Satsuma3D/Satsuma-250/README.md

# Satsuma 250

This project is incomplete. I might pick it up one day, or you are welcome to yourselves.

GPLv3 Licensed.

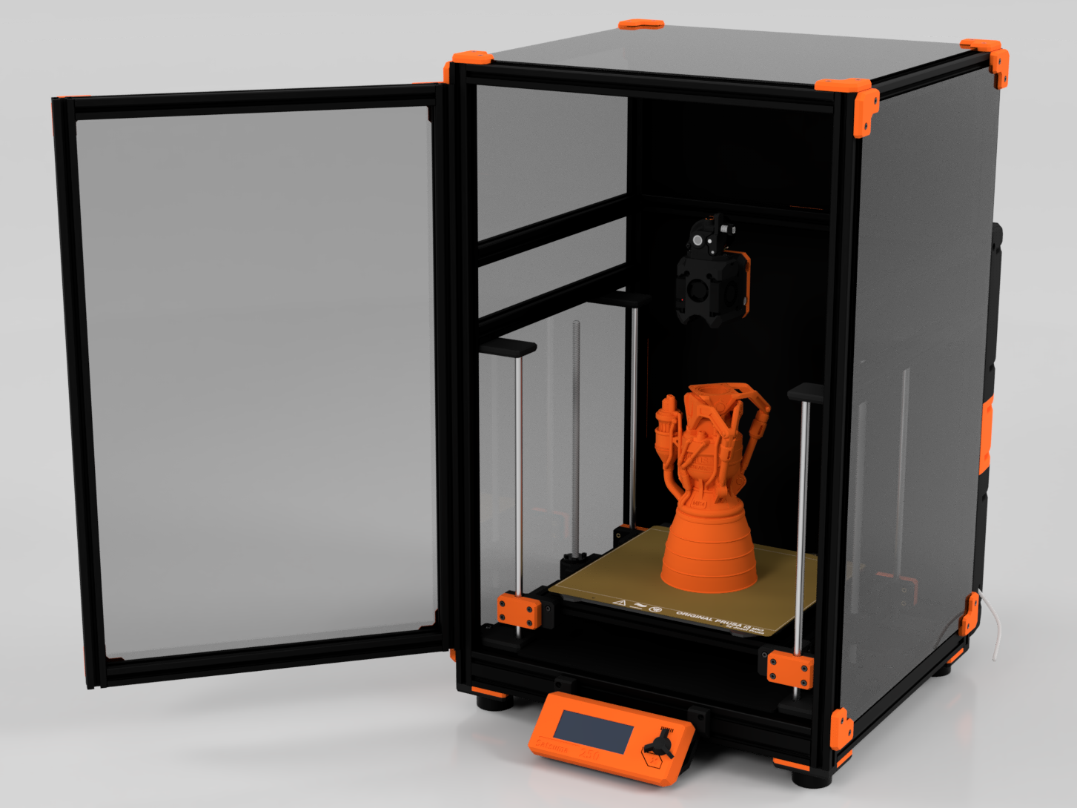
[picture p1: Assets/satsuma_250_front_render.png]
Front Render


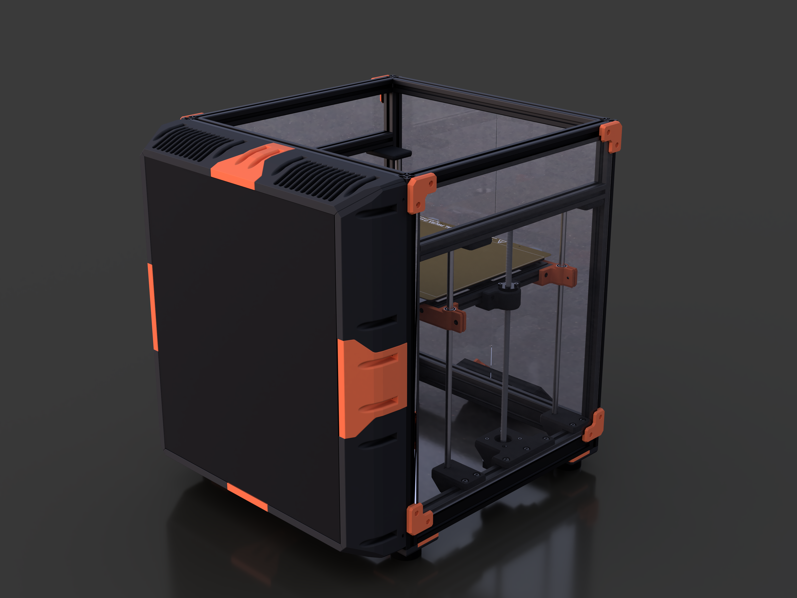
[picture p2: Assets/satsuma_250_rear_render.png]
Rear Render
