Satsuma3D/Satsuma-250/Assets/satsuma_250_electronics_bay.png

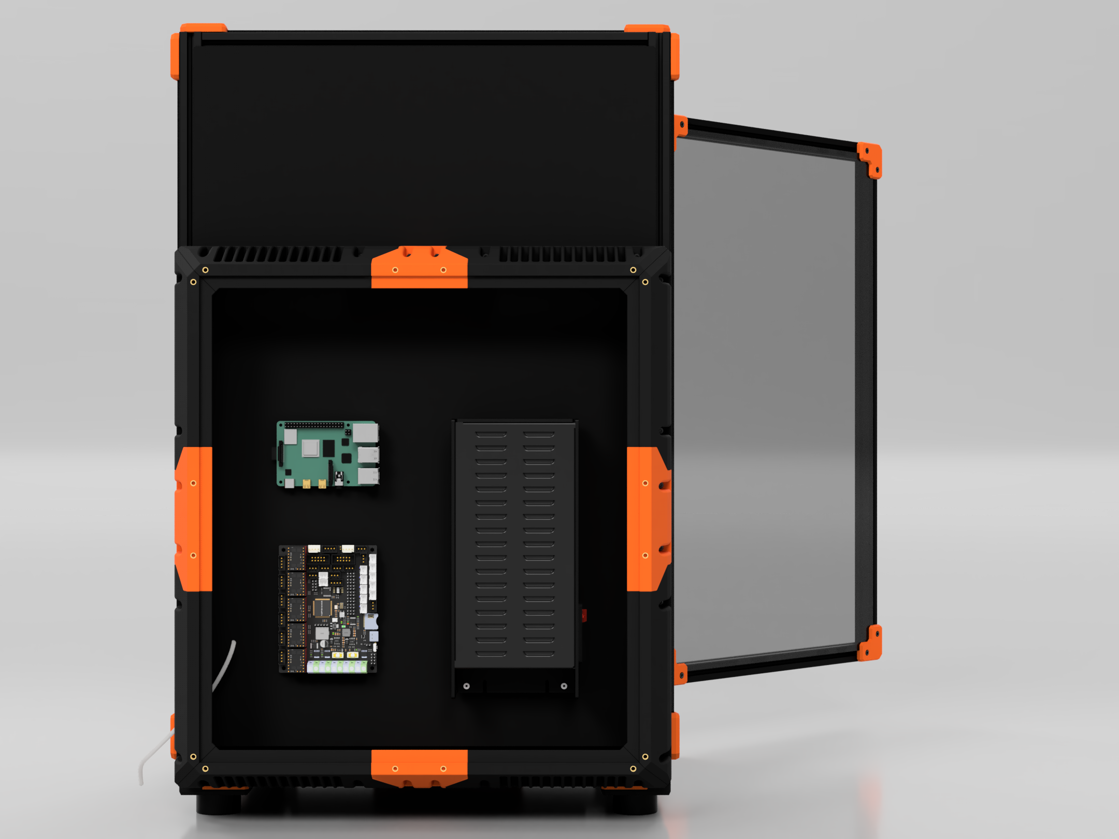
Assets/satsuma_250_electronics_bay.png
