Satsuma3D/Satsuma-250/Bill of Materials.ods

Item | Quantity | Selected | Selected Price | Selected Subtotal | Europe Price | Prusa Price | AliExpress Price | Europe Subtotal Price | Prusa Subtotal Price | AliExpress Subtotal Price | Europe | Prusa | AliExpress
3mm x 250mm Stainless 304 Rod | 4 | AliExpress | €1.25 | €4.98 | €1.25 | €1.25 | €1.25 | €4.98 | €4.98 | €4.98 |  | Unavailable | https://www.aliexpress.com/item/1005006238408009.html
8mm x 330mm Stainless 304 Rod | 2 | AliExpress | €6.14 | €12.28 | €13.53 | €11.99 | €6.14 | €27.06 | €23.98 | €12.28 |  | https://www.prusa3d.com/en/product/smooth-rod-y-axis-mk4-mk3-s-mk2-5-s-mk2-s/ | https://www.aliexpress.com/item/1005006238408009.html
8mm x 370mm Stainless 304 Rod | 2 | AliExpress | €7.50 | €15.00 | €15.17 | €11.99 | €7.50 | €30.34 | €23.98 | €15.00 |  | https://www.prusa3d.com/en/product/smooth-rod-x-axis-mk4-mk3-s-mk2-5-s-mk2-s/ | https://www.aliexpress.com/item/32697715625.html
8mm x 320mm Stainless 304 Rod | 4 | AliExpress | €6.07 | €24.26 | €13.12 | €11.64 | €6.07 | €52.48 | €46.56 | €24.26 |  | https://www.prusa3d.com/en/product/smooth-rod-z-axis-mk3-s-mk2-5-s-mk2-s/ | https://www.aliexpress.com/item/32761168449.html
Prusa MK3/MK4 Y Carriage | 1 | Europe | €37.73 | €37.73 | €36.49 | €37.90 | €37.73 | €36.49 | €37.90 | €37.73 | Hobby Store (Poland) https://hobby-store.pl/en/heated-beds/y-axis-carriage-replacement-for-prusa-i3-mk3.html | https://www.prusa3d.com/en/product/y-carriage/ | https://www.aliexpress.com/item/1005006019454008.html
Prusa MK52 Heated Bed 24V | 1 | Europe | €91.45 | €91.45 | €91.45 | €109.00 | €60.74 | €91.45 | €109.00 | €60.74 | Lecktor https://lecktor.com/en/heated-beds/30-mk52-24v-heated-bed.html | https://www.prusa3d.com/en/product/heatbed-mk52-24v-xbuddy-replacement-set/ | https://www.aliexpress.com/item/1005006074818817.html
TR8x4 Trapezoid Lead Screw Nut | 2 | Prusa | €13.94 | €27.88 |  | €13.94 | €0.00 | €0.00 | €27.88 | €0.00 |  | https://www.prusa3d.com/en/product/trapezoid-nut-i3-mk4-mmu2-2s-3/ | Blurolls included if you buy their motor
5015 Blower Fan 24V | 1 | Prusa | €7.49 | €7.49 |  | €7.49 | €14.22 | €0.00 | €7.49 | €14.22 |  | Not 24V but is 5V, will need wiring to 5V if you intend to pair it with the SKR Mini E3 https://www.prusa3d.com/en/product/print-fan/ | https://www.aliexpress.com/item/1005002065432445.html
4010 Hotend Fan 24V | 1 | Prusa | €13.49 | €13.49 |  | €13.49 | €12.12 | €0.00 | €13.49 | €12.12 |  | Not 24V but is 5V, will need wiring to 5V if you intend to pair it with the SKR Mini E3 https://www.prusa3d.com/en/product/hotend-fan-mk3-s/ | https://www.aliexpress.com/item/32726640438.html
F623 Bearing | 20 | Europe | €0.84 | €16.80 | €0.84 | €5.80 | €0.50 | €16.80 | €116.00 | €10.08 | Hobby Store (Poland) https://hobby-store.pl/en/ball-bearings/flanged-bearing-f623-rs-3x11x4mm.html | Not a direct equivalent, please use F623s as these will not work https://www.prusa3d.com/en/product/bearing-housing-623h/ | Mellow https://www.aliexpress.com/item/32660308298.html
Prusa X Motor | 1 | Europe | €24.75 | €24.75 | €24.75 | €38.89 | €34.33 | €24.75 | €38.89 | €34.33 | Jacks Filament (bundle, genuine LDO) Contains the extruder motor which will not be used https://www.jacksfilament.com/LDO-Prusa-MK3-Motor-Stepper-Kit | https://www.prusa3d.com/en/product/stepper-motor-x-axis-mk3-s-mk2-5-s-mk2-s/ | Blurolls Moons https://www.aliexpress.com/item/4001217753699.html
Prusa Y Motor | 1 | Europe | €24.75 | €24.75 | €24.75 | €38.39 | €34.33 | €24.75 | €38.39 | €34.33 | Jacks Filament (bundle, genuine LDO) Contains the extruder motor which will not be used https://www.jacksfilament.com/LDO-Prusa-MK3-Motor-Stepper-Kit | https://www.prusa3d.com/en/product/stepper-motor-y-axis-mk3-s-mk2-5-s-mk2-s/ | Blurolls Moons https://www.aliexpress.com/item/4001217753699.html
Prusa Z Axis Motor with R8x4 Lead Screw | 2 | Prusa | €38.89 | €77.78 |  | €38.89 | €34.10 | €0.00 | €77.78 | €68.20 |  | https://www.prusa3d.com/en/product/stepper-motor-z-axis-right-mk3-s-mk2-5-s-mk2-s/ | https://www.aliexpress.com/item/4001346400285.html
 |  |  |  | Selected Total |  |  |  | Europe Total | Prusa Total | AliExpress Total |  | Savings by not buying Prusa
 |  |  |  | €378.64 |  |  |  | €309.10 | €566.32 | €328.27 |  | €187.68
