Satsuma3D/Satsuma-250/Printed Parts/STEP/Bed Assembly/z_bearing_holder_a_x2.step

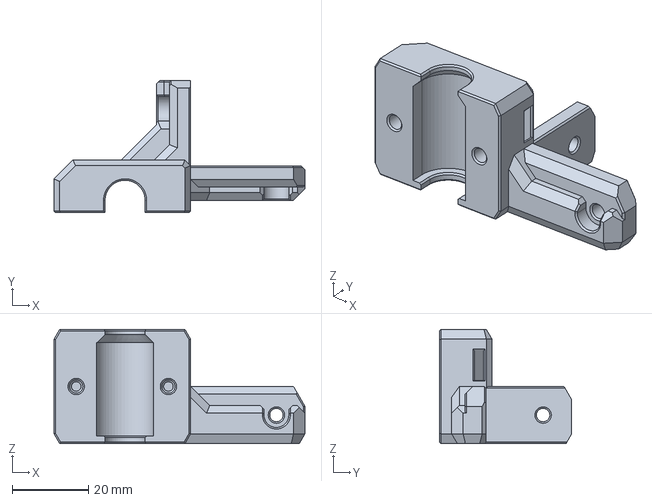
[picture p4: CAD file, 2024-11-23]
Printed Parts/STEP/Bed Assembly/z_bearing_holder_a_x2.step
65.8 x 34.8 x 30.0 mm
