Satsuma3D/Satsuma-250/Printed Parts/STEP/Z Axis/z_axis_bottom_x2.step

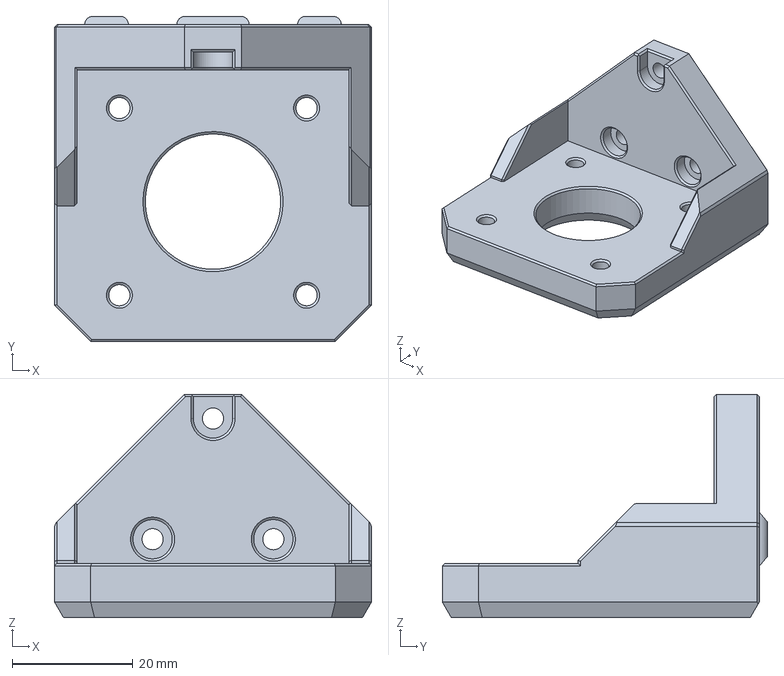
[picture p5: CAD file, 2024-11-23]
Printed Parts/STEP/Z Axis/z_axis_bottom_x2.step
52.5 x 53.9 x 37.0 mm
