Satsuma3D/Satsuma-250/Printed Parts/STEP/Bed Assembly/[a]_z_bearing_clamp_x4.step

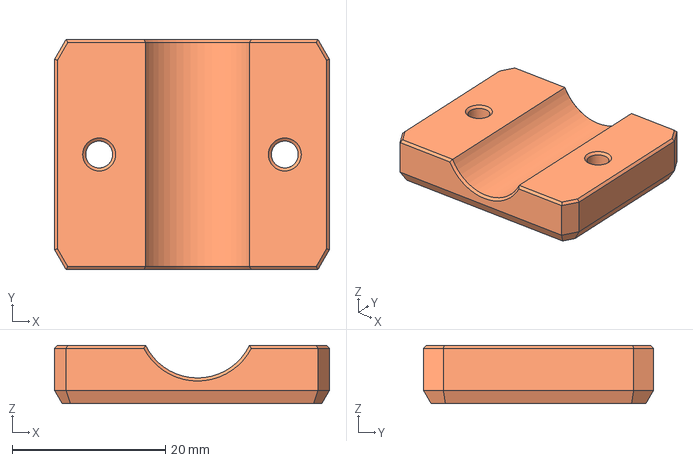
[picture p6: CAD file, 2024-11-23]
Printed Parts/STEP/Bed Assembly/[a]_z_bearing_clamp_x4.step
35.9 x 30.0 x 7.60 mm
