Satsuma3D/Satsuma-250/Printed Parts/STEP/Z Axis/z_rod_bottom_x4.step

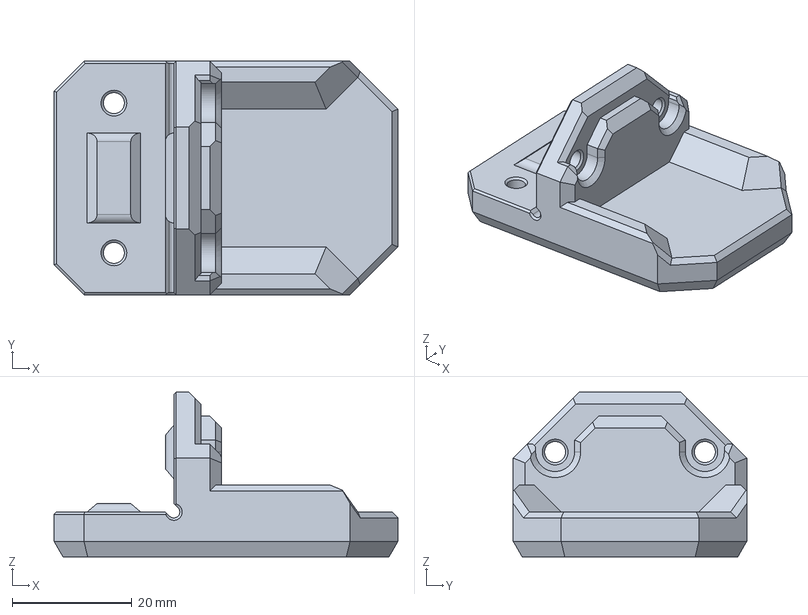
[picture p7: CAD file, 2024-11-23]
Printed Parts/STEP/Z Axis/z_rod_bottom_x4.step
57.4 x 39.0 x 27.5 mm
