Satsuma3D/Satsuma-250/Printed Parts/STEP/Z Axis/[a]_z_rod_top_b_x2.step

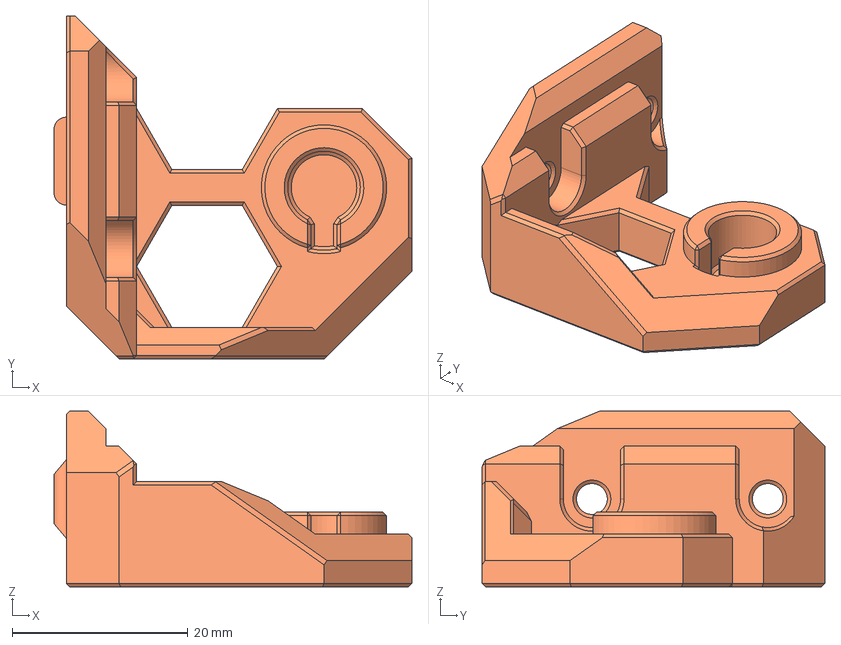
[picture p8: CAD file, 2024-11-23]
Printed Parts/STEP/Z Axis/[a]_z_rod_top_b_x2.step
40.7 x 39.0 x 20.0 mm
