Satsuma3D/Satsuma-250/(list of files, cad)

Other CAD files:
Printed Parts/STEP/Z Axis/[a]_z_rod_top_a_x2.step
CAD/Clementine 240.f3d
Printed Parts/F3D/Bed Assembly/[a]_z_bearing_clamp_x4.f3d
Printed Parts/F3D/Bed Assembly/z_bearing_holder_a_x2.f3d
Printed Parts/F3D/Z Axis/[a]_z_rod_top_a_x2.f3d
Printed Parts/F3D/Z Axis/[a]_z_rod_top_b_x2.f3d
Printed Parts/F3D/Z Axis/z_axis_bottom_x2.f3d
Printed Parts/F3D/Z Axis/z_rod_bottom_x4.f3d
Printed Parts/STL/Bed Assembly/[a]_z_bearing_clamp_x4.stl
Printed Parts/STL/Bed Assembly/z_bearing_holder_a_x2.stl
Printed Parts/STL/Z Axis/[a]_z_rod_top_a_x2.stl
Printed Parts/STL/Z Axis/[a]_z_rod_top_b_x2.stl
Printed Parts/STL/Z Axis/z_axis_bottom_x2.stl
Printed Parts/STL/Z Axis/z_rod_bottom_x4.stl
