Satsuma3D/Satsuma-250/(commit log)

2024-03-17 Update CAD
2024-03-18 Single Y extrusions
2024-03-29 CT36 Toolhead PCB
    [2132282210.step, 436500210.step, 5023860270.step, 5023860370.step, 5023860470.step, Bill of Materials.ods, toolhead_board.kicad_pcb, toolhead_board.kicad_sch]
2024-03-29 4 layer board
    [5023820470.step, toolhead_board.kicad_pcb, toolhead_board.kicad_sch]
2024-03-29 Belt paths
2024-03-30 New A/B motor assemblies
2024-03-30 Bridge cutting A/B mounts, Git LFS
    [2132282210.step, 436500210.step, 5023820470.step, 5023860270.step, 5023860370.step, 5023860470.step]
2024-03-30 Add blind joints to frame
    [Clementine 240.f3d]
2024-03-30 Front frame blind joints are different; add gantry fasteners
    [Clementine 240.f3d]
2024-03-30 Fix side panel sizing
    [Clementine 240.f3d]
2024-03-30 Y endstop pod
    [Clementine 240.f3d]
2024-03-30 Cleanup the look of that ugly door
    [Clementine 240.f3d]
2024-03-30 Nicer side panels
    [Clementine 240.f3d]
2024-03-31 XY Joints
    [Clementine 240.f3d]
2024-04-01 Front idlers - cheers, Clee
    [Clementine 240.f3d]
2024-04-01 Electronics re-jig, cleaner XY joint tops
    [Clementine 240.f3d]
2024-04-01 Use filtered mains inlets
    [Clementine 240.f3d]
2024-04-01 Begun filtered mains IEC
    [Clementine 240.f3d]
2024-04-03 Frame updates
    [Clementine 240.f3d, Toolhead.f3d]
2024-04-03 Remove Git LFS
    [2132282210.step, 436500210.step, 5023820470.step, 5023860270.step, 5023860370.step, 5023860470.step, Toolhead.f3d]
2024-04-23 Satsuma 250 from here on
    [2132282210.step, 436500210.step, 5023820470.step, 5023860270.step, 5023860370.step, 5023860470.step, toolhead_board.kicad_pcb, toolhead_board.kicad_sch]
2024-04-23 Toolhead layout
    [Toolhead.f3d]
2024-05-07 Bed mounting refinements
2024-05-08 Top Z mount
2024-05-11 Z rod joints complete
2024-05-12 Gantry update
2024-05-15 A Belt
2024-05-17 Refined motor mounts and top rod mounts
    [z_motor_mount_a_x2.stl, z_top_mount_a_x2.stl, z_top_mount_b_x2.stl]
2024-05-17 Trident Z leadscrew support
    [z_top_mount_a_prusa_x2.stl, z_top_mount_a_trident_x2.stl, z_top_mount_a_x2.stl, z_top_mount_b_prusa_x2.stl, z_top_mount_b_trident_x2.stl, z_top_mount_b_x2.stl]
2024-05-20 Begin frame
    [Frame.step]
2024-05-22 Frame preparation
2024-05-22 Blind joint preparation
    [Frame Bolts.step]
2024-05-23 Faster process entirely in Fusion
    [Frame Bolts.step, Frame.step]
2024-05-23 First blind joint
2024-05-28 New gantry
    [Bill of Materials.ods]
2024-05-28 Update screws
2024-05-28 Cleanup screws
2024-05-29 5mm rods
2024-06-15 Z motor mounts for quad motors
2024-06-15 Polish Z motor mounts, foot corners
    [[a]_foot_corner_accent_x4.stl, foot_corner_x4.stl, z_motor_mount_a_x2.stl, z_motor_mount_b_x2.stl, z_motor_mount_trident_a_x2.stl, z_motor_mount_trident_b_x2.stl, z_top_mount_a_prusa_x2.stl, z_top_mount_a_trident_x2.stl]
2024-06-15 Fix mirrored text on motor B mounts
    [z_motor_mount_b_x2.stl, z_motor_mount_trident_b_x2.stl]
2024-06-16 Fix corner chamfer printability
    [foot_corner_x4.stl, z_motor_mount_a_x2.stl, z_motor_mount_b_x2.stl, z_motor_mount_trident_a_x2.stl, z_motor_mount_trident_b_x2.stl]
2024-06-16 Improved cross bridge and horizontal holes
    [foot_corner_x4.stl, z_motor_mount_a_x2.stl, z_motor_mount_trident_a_x2.stl]
2024-07-21 Parametric assembly
    [[a]_foot_corner_accent_x4.stl, foot_corner_x4.stl, z_motor_mount_a_x2.stl, z_motor_mount_b_x2.stl, z_motor_mount_trident_a_x2.stl, z_motor_mount_trident_b_x2.stl, z_motor_plate_x2.stl, z_rod_bottom_plate_x4.stl]
2024-07-21 Bed extrusions
    [z_motor_plate_x2.stl, z_rod_bottom_plate_x4.stl, z_rod_top_plate_x4.stl]
2024-07-21 Fix top plate rod alignment
    [z_rod_top_plate_x4.stl]
2024-07-21 Finalizing the bed
    [[a]_z_bearing_clamp_a_x2.stl, [a]_z_bearing_clamp_b_x2.stl, z_bearing_bracket_a_x2.stl, z_bearing_bracket_b_x2.stl]
2024-07-22 Fix bed mounting, add bearing cutouts
    [[a]_z_bearing_clamp_a_x2.stl, [a]_z_bearing_clamp_b_x2.stl, z_bearing_bracket_a_x2.stl, z_bearing_bracket_b_x2.stl]
2024-07-22 Fix bed bracket B chamfer
    [z_bearing_bracket_b_x2.stl]
2024-07-22 Leadscrew nut blocks
    [[a]_z_bearing_clamp_a_x2.stl, [a]_z_bearing_clamp_b_x2.stl, leadscrew_nut_bracket_x2.stl, z_bearing_bracket_a_x2.stl, z_bearing_bracket_b_x2.stl, z_motor_plate_x2.stl, z_rod_bottom_plate_x4.stl, z_rod_top_plate_x4.stl]
2024-07-22 Re export rod plates
    [z_rod_bottom_plate_x4.stl, z_rod_top_plate_x4.stl]
2024-07-22 Fix MakerbeamXL slot width
2024-08-17 Material fixes
2024-08-18 PTFE tube entry
2024-08-18 LCD mounts
2024-08-21 Updating bed bearing holders
2024-08-21 New bed mounts
2024-11-11 Add rubber feet final parts
    [[a]_foot_corner_accent_x4.step, [a]_foot_corner_accent_x4.stl, foot_corner_x4.step, foot_corner_x4.stl]
2024-11-13 Add bed corners
    [z_bearing_holder_a_x2.step, z_bearing_holder_a_x2.stl, z_bearing_holder_b_x2.step, z_bearing_holder_b_x2.stl]
2024-11-20 Updating designs
    [[a]_foot_corner_accent_x4.step, [a]_foot_corner_accent_x4.stl, foot_corner_x4.step, foot_corner_x4.stl, frame_drill_guide_x4.step, frame_drill_guide_x4.stl, z_axis_bottom_x2.f3d, z_axis_bottom_x2.step]
2024-11-23 Export final Z rod parts; motor plates
    [[a]_z_rod_top_a_x2.f3d, [a]_z_rod_top_a_x2.step, [a]_z_rod_top_a_x2.stl, [a]_z_rod_top_b_x2.f3d, [a]_z_rod_top_b_x2.step, [a]_z_rod_top_b_x2.stl, z_axis_bottom_x2.f3d, z_axis_bottom_x2.step]
2024-11-23 Bed bearing corners
    [[a]_z_bearing_clamp_x4.f3d, [a]_z_bearing_clamp_x4.step, [a]_z_bearing_clamp_x4.stl, z_bearing_holder_a_x2.f3d, z_bearing_holder_a_x2.step, z_bearing_holder_a_x2.stl]
2025-04-15 Upload incomplete CAD
